stav98/Washing-Machine/src/Readme.md

Όλος ο πηγαίος κώδικας για το ESP32.
Χρησιμοποιώ και τους δύο πυρήνες του controller.
