stav98/Washing-Machine/harware/Readme.md

Εδώ υπάρχουν τα σχέδια σε pdf και sch για eagle.
