stav98/Washing-Machine/harware/WashingMachine.pdf

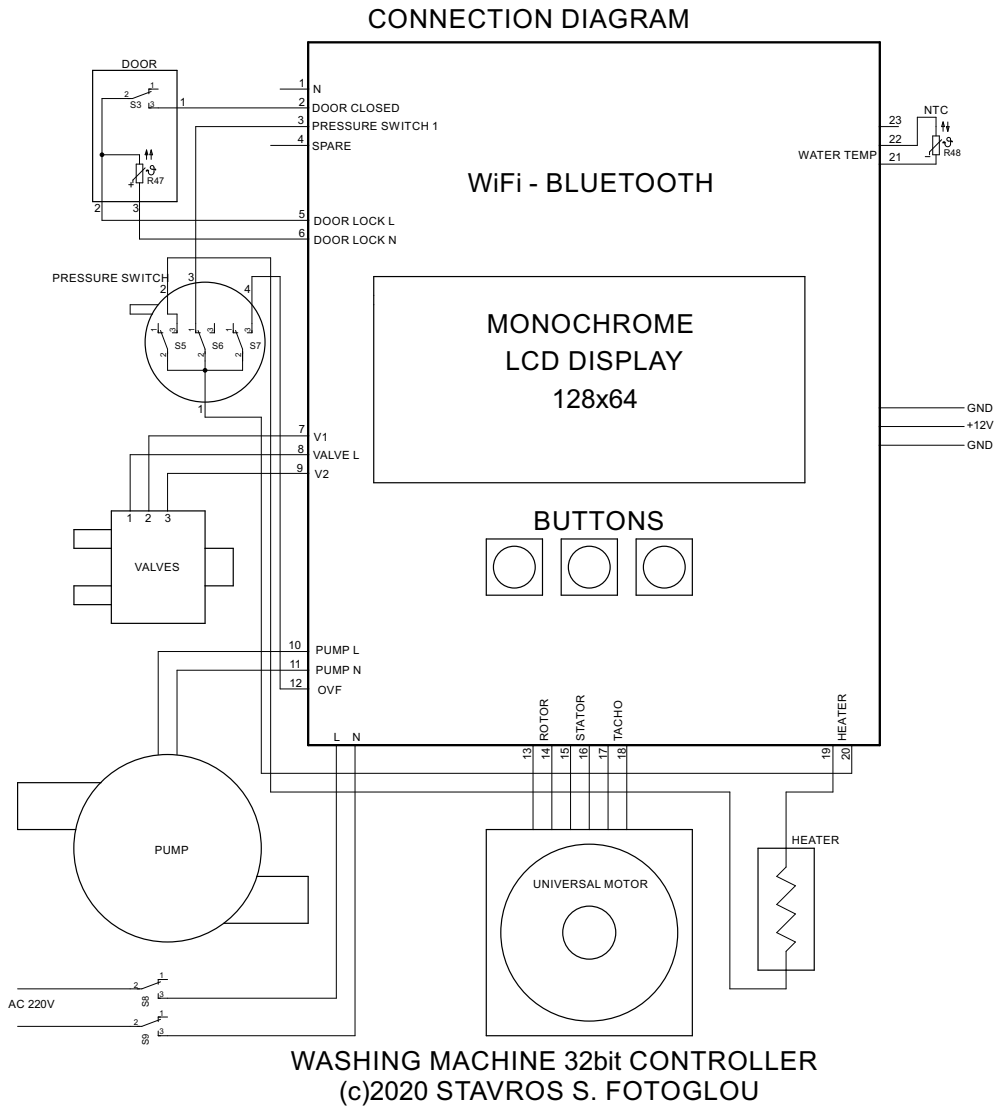
[picture p1: page 1]

10
11

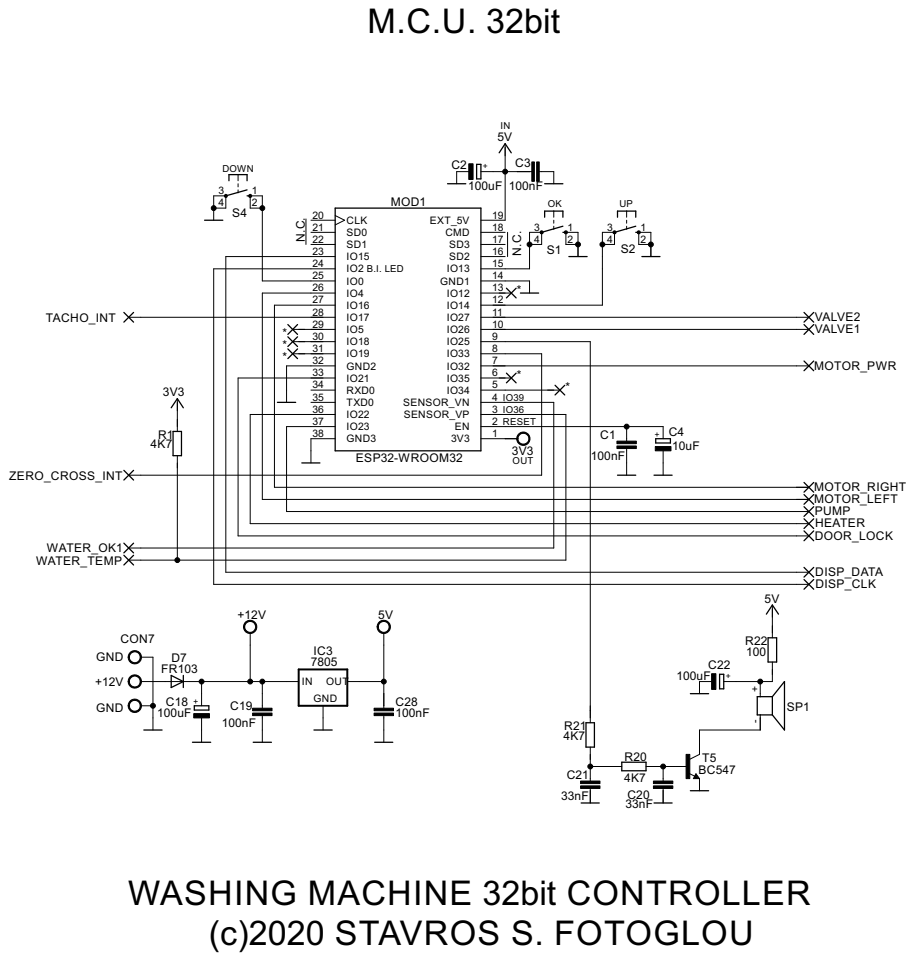
[picture p2: page 2]

2 SENSOR_VP RESET

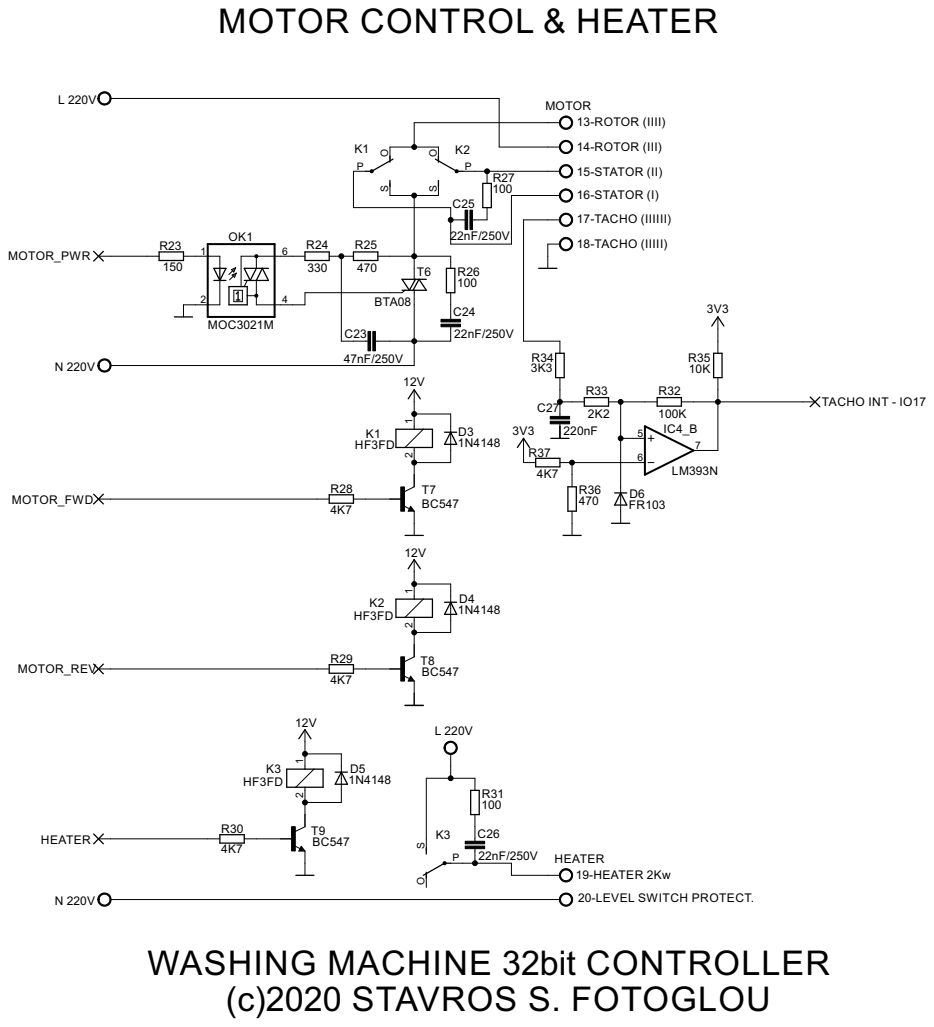
[picture p3: page 3]

MOTOR
13-ROTOR (IIII) 14-ROTOR (III) 15-STATOR (II) 16-STATOR (I) 17-TACHO (IIIIII) 18-TACHO (IIIII)

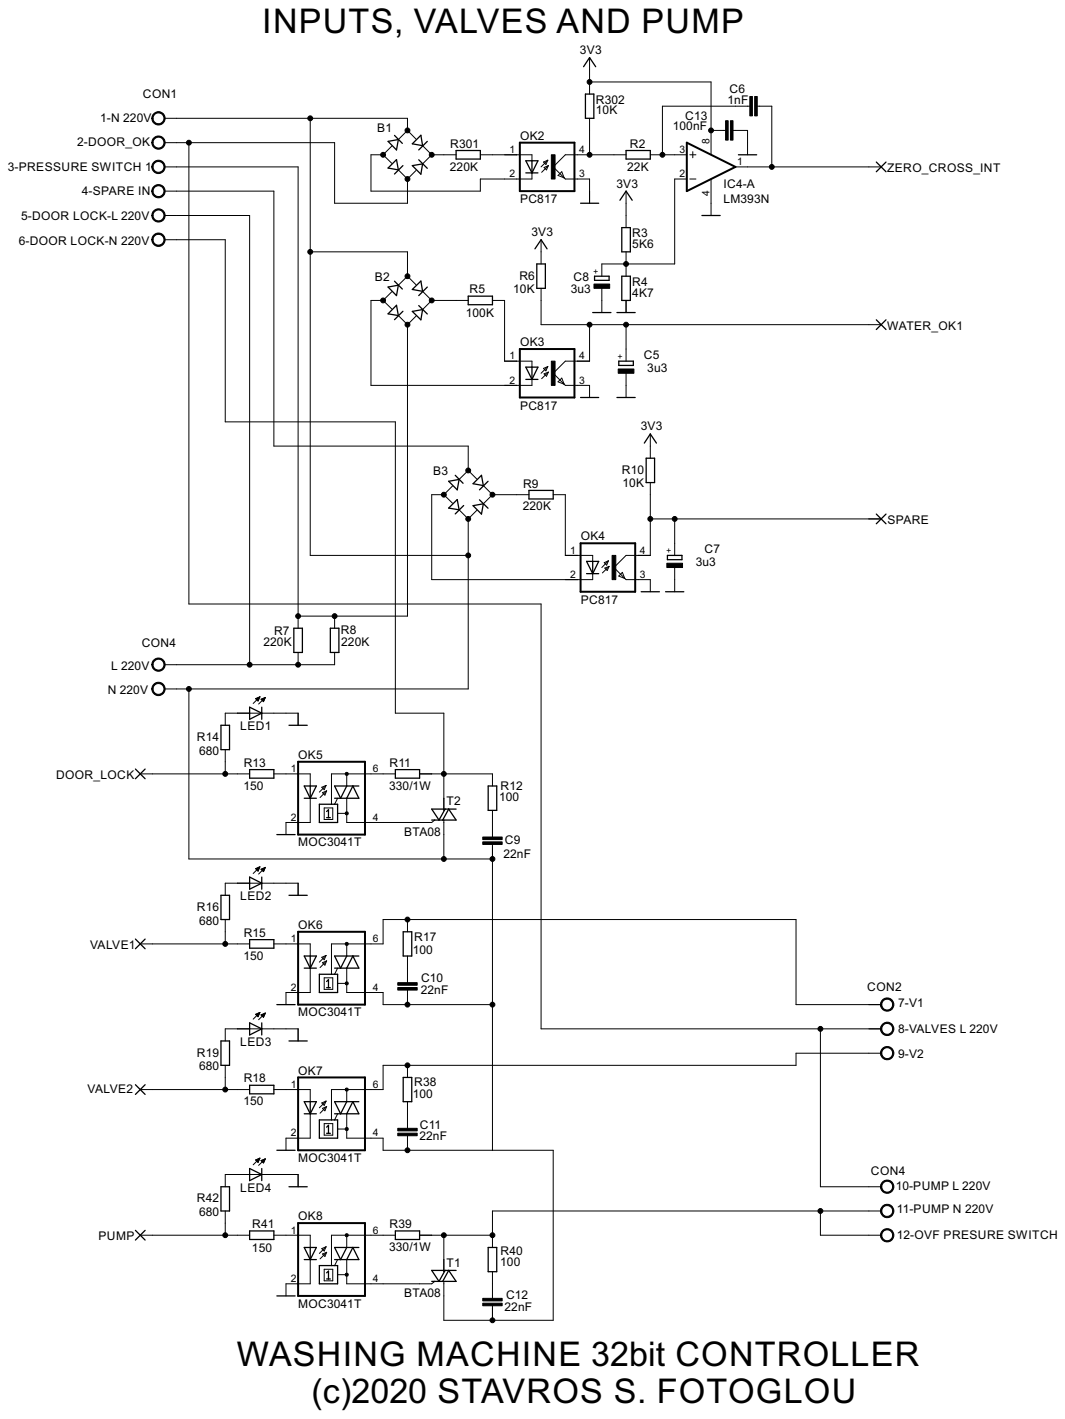
[picture p4: page 4]

INPUTS, VALVES AND PUMP

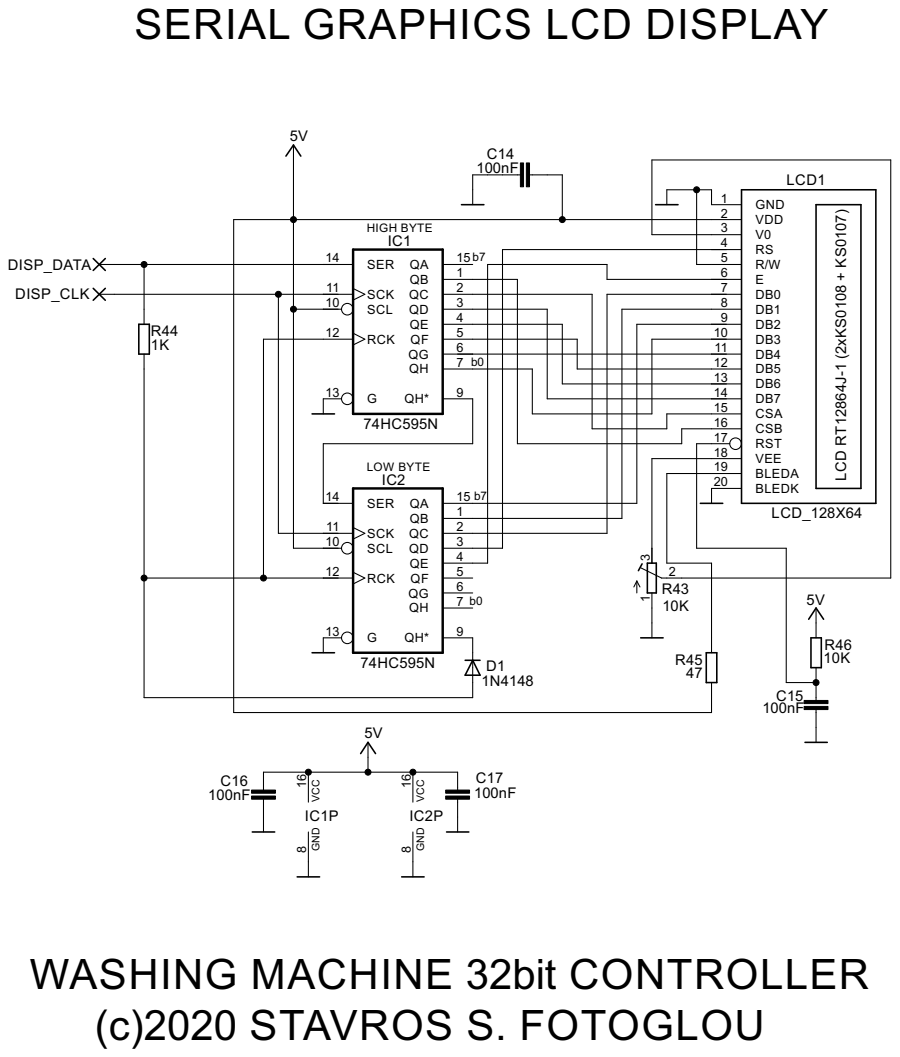
[picture p5: page 5]

SERIAL GRAPHICS LCD DISPLAY

1 QC
2 QD
3 QE
4 QF 5 QG
