stav98/Washing-Machine/harware/WashingMachine.sch

## EAGLE design harware/WashingMachine.sch (2020-10-03)

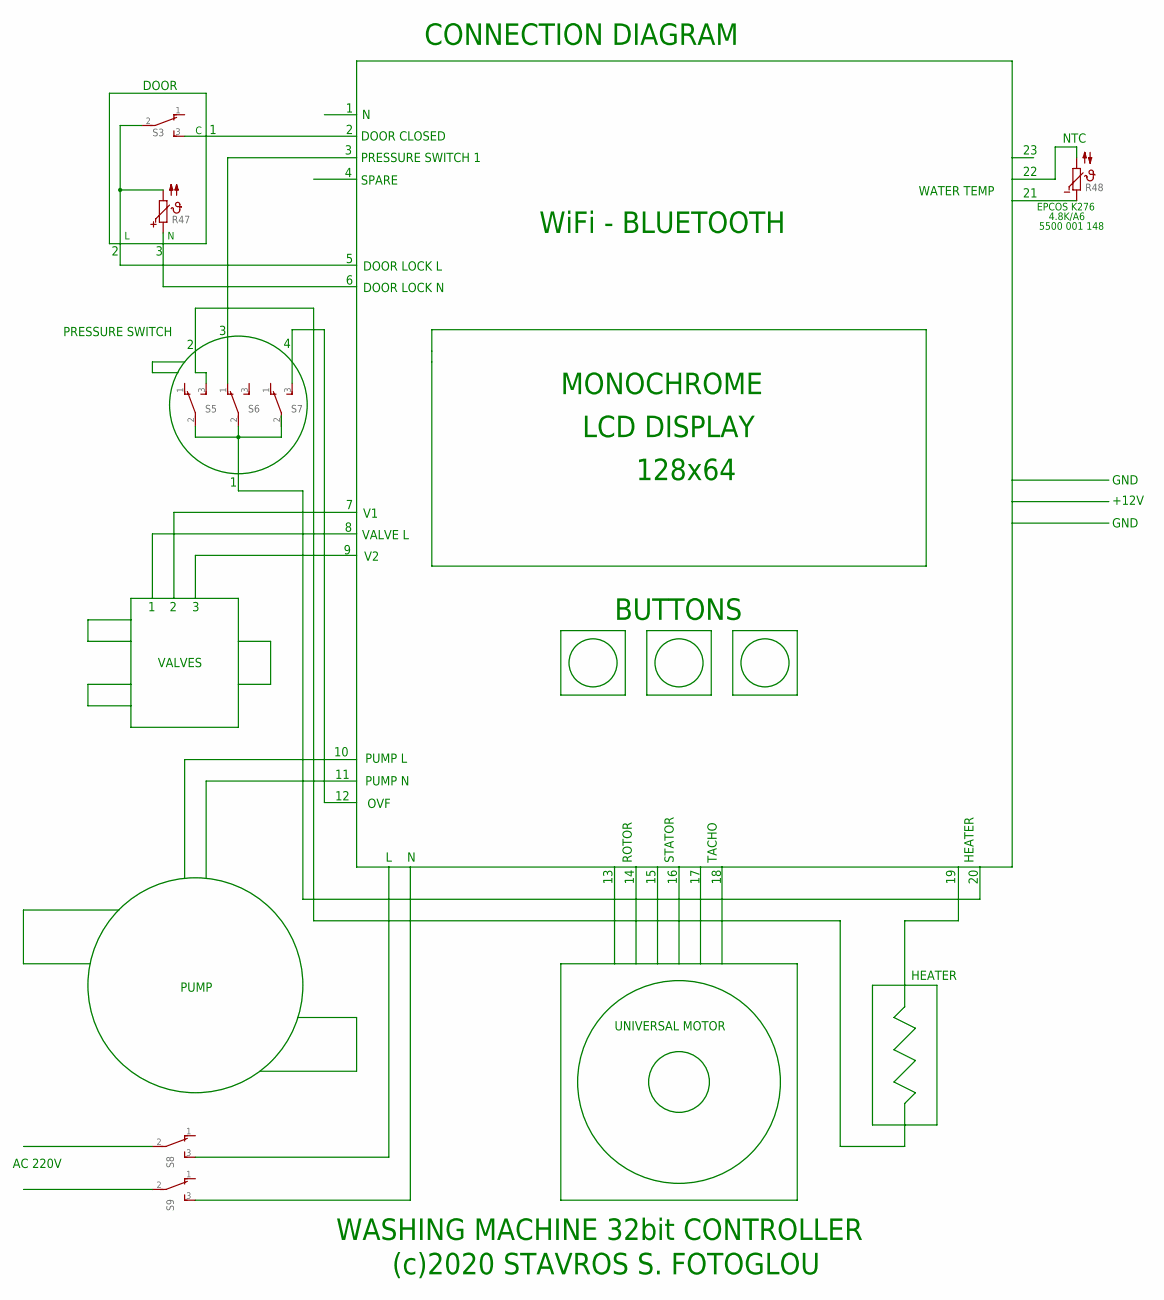
[picture p6: schematic WashingMachine.sch, sheet 1]

Parts:
R47: PTC679; P679
R48: NTC640-9; N640
S3, S5, S6, S7, S8, S9: TL36WO; TL3XWO

Connections:
unnamed: R47.1, R47.2, R48.1, R48.2, S3.2, S3.3 (S), S5.2, S5.3 (S), S6.1 (O), S6.2, S7.2, S7.3 (S), S8.3 (S), S9.3 (S)

Notes on the sheet:
DOOR CLOSED
DOOR LOCK L
DOOR LOCK N
PRESSURE SWITCH 1
DOOR
PRESSURE SWITCH
VALVE L
PUMP L
PUMP N
OVF
AC 220V
ROTOR
STATOR
TACHO
HEATER
GND
+12V
UNIVERSAL MOTOR
PUMP
VALVES
NTC
MONOCHROME
LCD DISPLAY
128x64
BUTTONS
WiFi - BLUETOOTH
WATER TEMP
SPARE
WASHING MACHINE 32bit CONTROLLER
(c)2020 STAVROS S. FOTOGLOU
CONNECTION DIAGRAM
EPCOS K276
4.8K/A6
5500 001 148

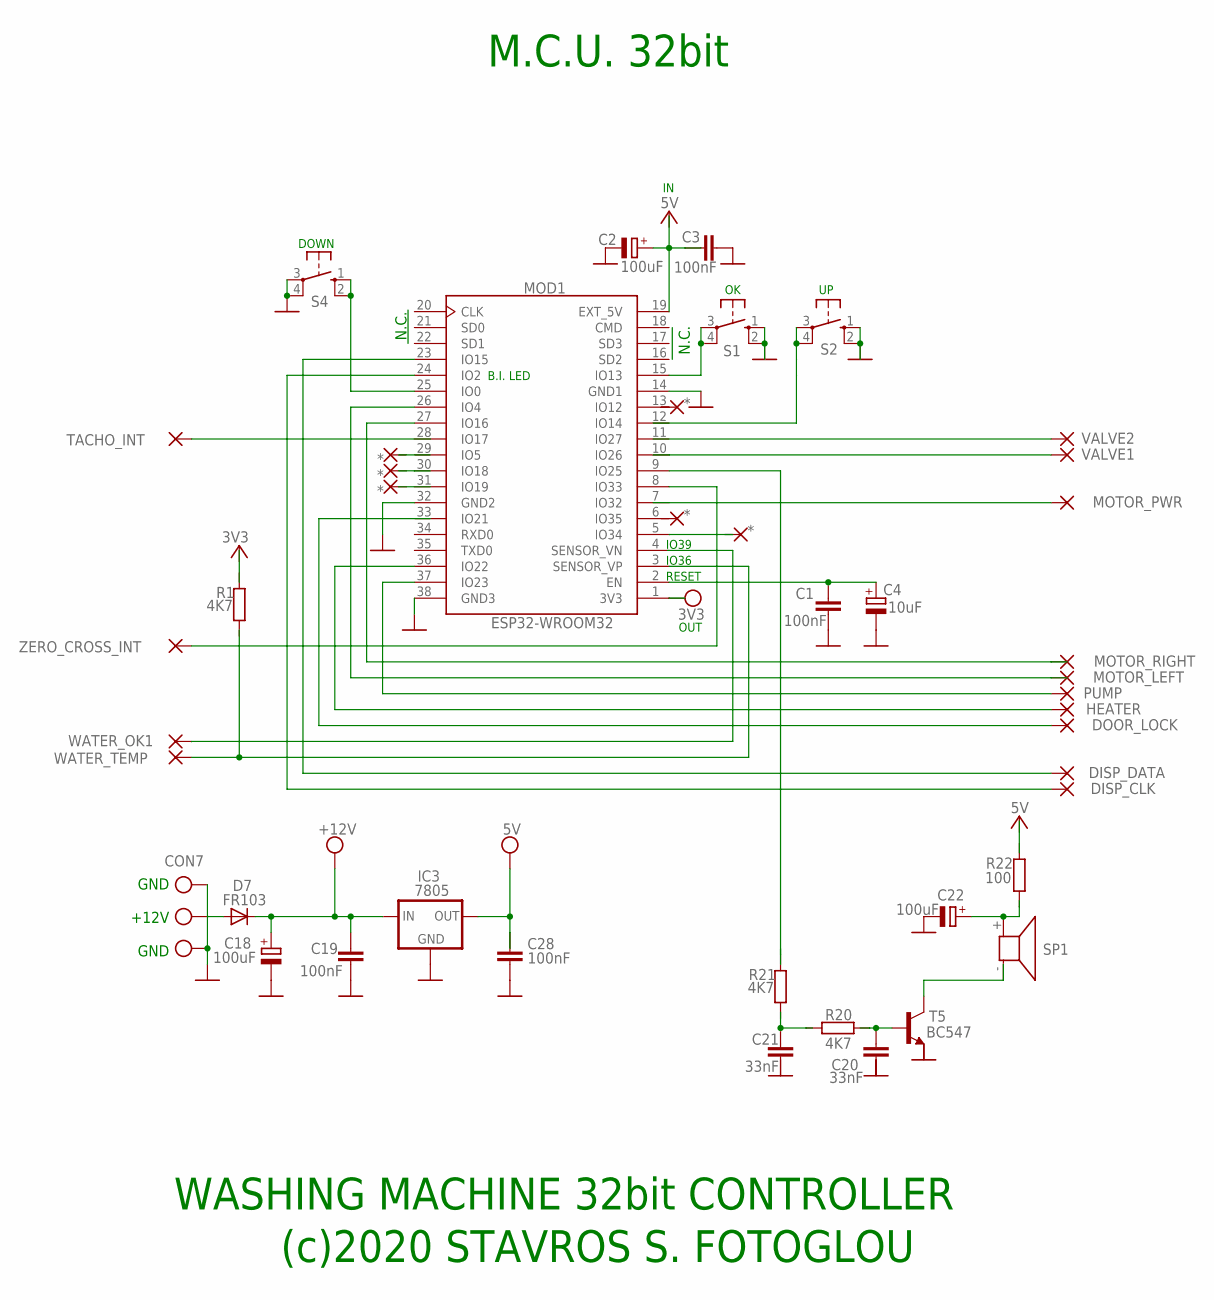
[picture p7: schematic WashingMachine.sch, sheet 2]

Parts:
C1, C3, C19, C28: 100nF; C2.5-2
C2, C18, C22: 100uF; E5-6
C4: 10uF; E5-6
C20, C21: 33nF; C2.5-2
D7: FR103; DO41-10
IC3: 7805; 78XXL
MOD1: ESP32-WROOM32; MODULE_ESP32-DEVKITC-32U
PAD1: MOTOR_RIGHT; 1,6/0,8
PAD2: MOTOR_LEFT; 1,6/0,8
PAD3: TACHO_INT; 1,6/0,8
PAD4: VALVE1; 1,6/0,8
PAD5: VALVE2; 1,6/0,8
PAD6: PUMP; 1,6/0,8
PAD7: HEATER; 1,6/0,8
PAD8: DOOR_LOCK; 1,6/0,8
PAD9: WATER_OK1; 1,6/0,8
PAD10: DISP_DATA; 1,6/0,8
PAD11: DISP_CLK; 1,6/0,8
PAD13, PAD14, PAD15, PAD24, PAD25, PAD34: *; 1,6/0,8
PAD30: WATER_TEMP; 1,6/0,8
PAD31: ZERO_CROSS_INT; 1,6/0,8
PAD32: MOTOR_PWR; 1,6/0,8
R1, R20, R21: 4K7; 0204/7
R22: 100; 0204/7
S1, S2, S4: 10-XX; B3F-10XX
SP1: AL11P
T5: BC547; TO92
X10: CON7; AK500/3

Connections:
GND: C1.2, C2.-, C3.1, C4.-, C18.-, C19.2, C22.-, C28.2, IC3.GND, MOD1.14 (GND1), MOD1.32 (GND2), MOD1.38 (GND3), S1.1 (S), S1.2 (S1), S2.1 (S), S2.2 (S1), S4.3, S4.4 (P1), X10.1, X10.3
unnamed: MOD1.3 (SENSOR_VP), PAD30.1
unnamed: MOD1.26 (IO4), PAD2.1
unnamed: MOD1.10 (IO26), PAD4.1
unnamed: MOD1.27 (IO16), PAD1.1
unnamed: MOD1.8 (IO33), PAD31.1
unnamed: MOD1.37 (IO23), PAD6.1
unnamed: MOD1.36 (IO22), PAD7.1
unnamed: C1.1, C4.+, MOD1.2 (EN)
unnamed: MOD1.23 (IO15), PAD10.1
unnamed: MOD1.24 (IO2), PAD11.1
unnamed: MOD1.15 (IO13), S1.3, S1.4 (P1)
unnamed: S2.3, S2.4 (P1)
unnamed: MOD1.25 (IO0), S4.1 (S), S4.2 (S1)
unnamed: D7.A, X10.2
unnamed: C20.1, R20.1, T5.2 (B)
unnamed: C21.1, R20.2, R21.2
unnamed: SP1.- (1), T5.3 (C)
unnamed: MOD1.9 (IO25), R21.1
unnamed: C22.+, R22.2, SP1.+ (2)
unnamed: C2.+, C3.2, MOD1.19 (EXT_5V)
VCC: C18.+, C19.1, C28.1, D7.C, IC3.IN, IC3.OUT, MOD1.1 (3V3)

Notes on the sheet:
RESET
IO39
IO36
N.C.
B.I. LED
DOWN
WASHING MACHINE 32bit CONTROLLER
(c)2020 STAVROS S. FOTOGLOU
OUT
M.C.U. 32bit
GND
+12V

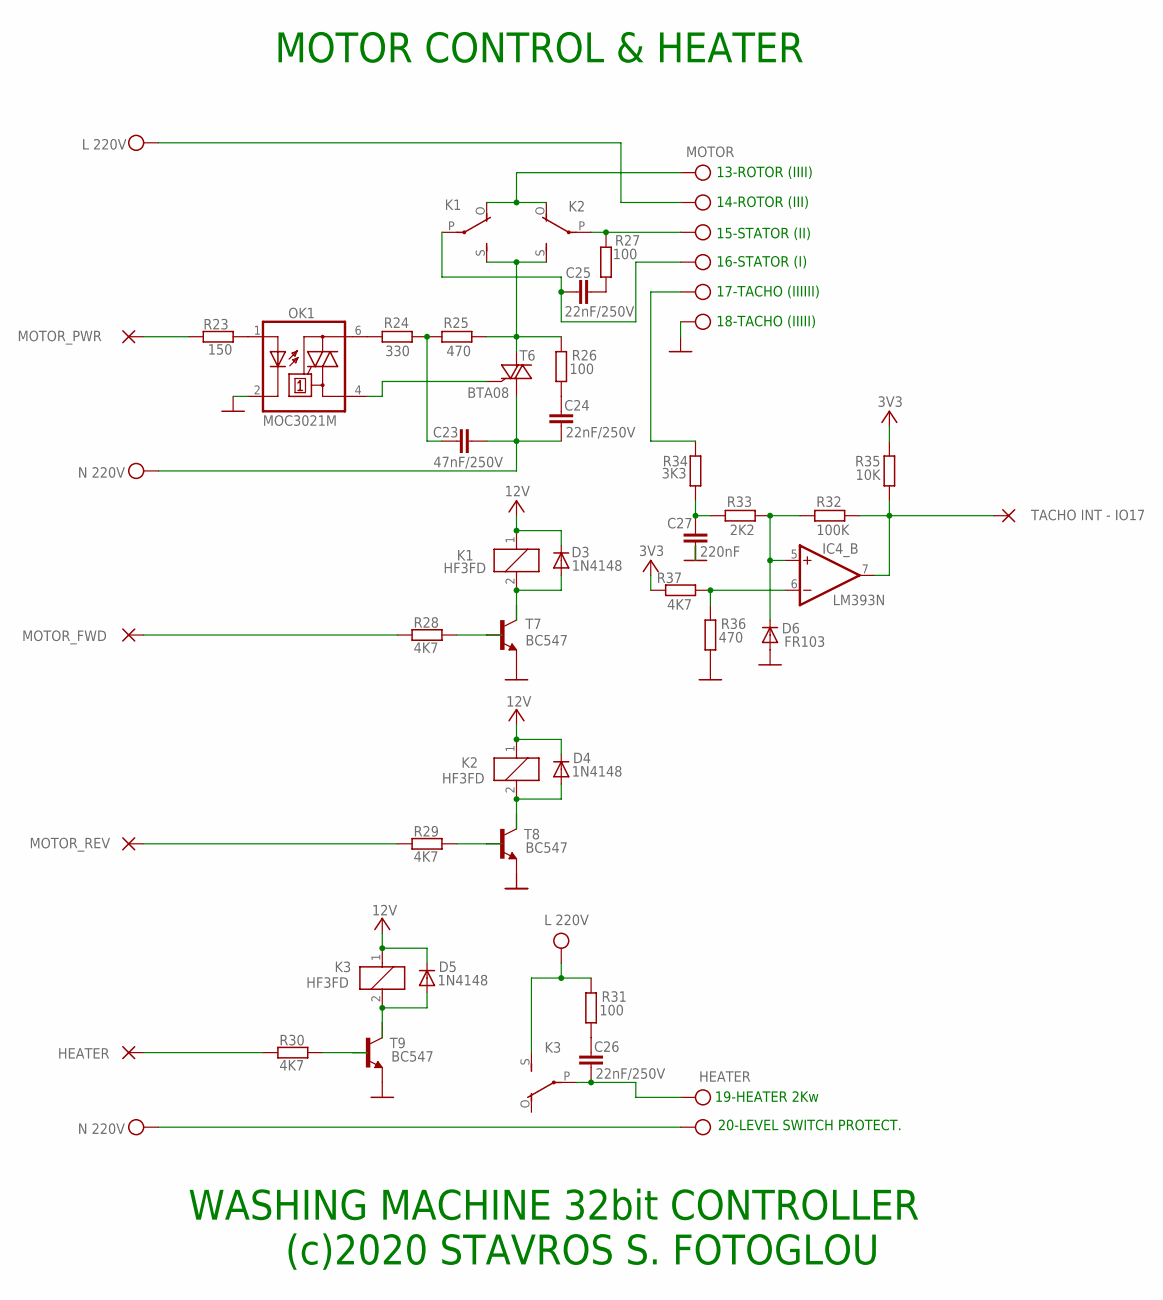
[picture p8: schematic WashingMachine.sch, sheet 3]

Parts:
C23: 47nF/250V; C050-025X075
C24, C25, C26: 22nF/250V; C050-025X075
C27: 220nF; C050-025X075
D3, D4, D5: 1N4148; DO35-10
D6: FR103; DO41-10
IC4_: LM393N; DIL08
K1, K2, K3: HF3FD; G5LE
OK1: MOC3021M; DIL06
PAD36: MOTOR_PWR; 2,15/1,0
PAD37: MOTOR_FWD; 2,15/1,0
PAD38: MOTOR_REV; 2,15/1,0
PAD39: HEATER; 2,15/1,0
PAD40: TACHO INT - IO17; 2,15/1,0
R23: 150; 0204/7
R24: 330; 0204/7
R25, R36: 470; 0204/7
R26, R27, R31: 100; 0204/7
R28, R29, R30, R37: 4K7; 0204/7
R32: 100K; 0204/7
R33: 2K2; 0204/7
R34: 3K3; 0204/7
R35: 10K; 0204/7
T6: BTA08; TO220AB
T7, T8, T9: BC547; TO92
X1: MOTOR; AK500/6
X2: HEATER; AK500/2

Connections:
GND: C27.1, D6.A, OK1.2 (C), R36.1, T7.1 (E), T8.1 (E), T9.1 (E), X1.1
unnamed: OK1.1 (A), R23.2
unnamed: PAD36.1, R23.1
unnamed: OK1.6 (A2), R24.1
unnamed: C23.1, R24.2, R25.1
unnamed: OK1.4 (A1), T6.3 (G)
unnamed: K1.S, K2.S, R25.2, R26.2, T6.2 (A2)
unnamed: K2.P, R27.2, X1.4
unnamed: C24.2, R26.1
unnamed: C25.1, K1.P, X1.3
unnamed: K1.O, K2.O, X1.6
unnamed: C25.2, R27.1
unnamed: PAD37.1, R28.1
unnamed: R28.2, T7.2 (B)
unnamed: D3.A, K1.2, T7.3 (C)
unnamed: PAD39.1, R30.1
unnamed: PAD38.1, R29.1
unnamed: R29.2, T8.2 (B)
unnamed: D4.A, K2.2, T8.3 (C)
unnamed: R30.2, T9.2 (B)
unnamed: D5.A, K3.2, T9.3 (C)
unnamed: C26.2, R31.1
unnamed: C26.1, K3.P, X2.2
unnamed: D6.C, IC4_.5 (+IN), R32.1, R33.2
unnamed: IC4_.7 (OUT), PAD40.1, R32.2, R35.1
unnamed: C27.2, R33.1, R34.1
unnamed: IC4_.6 (-IN), R36.2, R37.1
unnamed: R34.2, X1.2
VCC: C23.2, C24.1, D3.C, D4.C, D5.C, K1.1, K2.1, K3.1, K3.S, R31.2, R35.2, R37.2, T6.1 (A1), X1.5, X2.1

Notes on the sheet:
13-ROTOR (IIII)
14-ROTOR (III)
15-STATOR (II)
16-STATOR (I)
17-TACHO (IIIIII)
18-TACHO (IIIII)
19-HEATER 2Kw
20-LEVEL SWITCH PROTECT.
MOTOR CONTROL & HEATER
WASHING MACHINE 32bit CONTROLLER
(c)2020 STAVROS S. FOTOGLOU

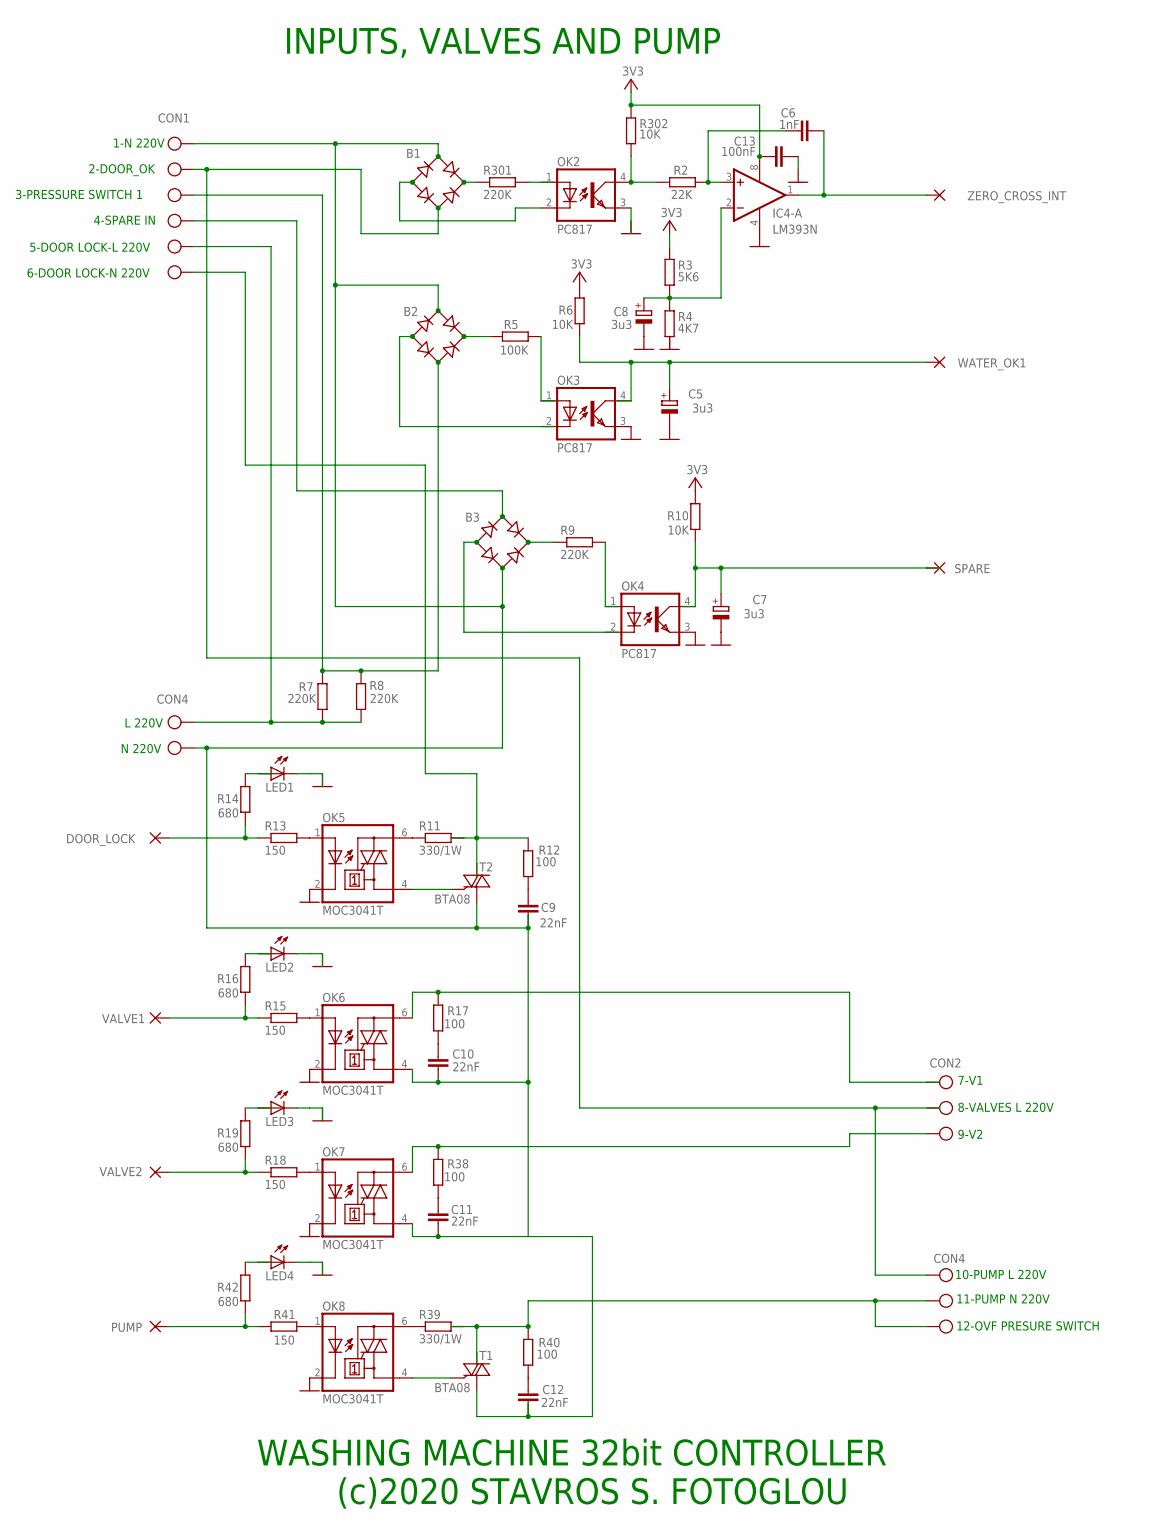
[picture p9: schematic WashingMachine.sch, sheet 4]

Parts:
B1, B2, B3: DBDB101G; DB
C5, C7, C8: 3u3; E5-6
C6: 1nF; C050-025X075
C9, C10, C11, C12: 22nF; C050-025X075
C13: 100nF; C050-025X075
IC4-: LM393N; DIL08
LED1, LED2, LED3, LED4: LED_ELD260; LED_LD260
OK2, OK3, OK4: PC817; DIL04
OK5, OK6, OK7, OK8: MOC3041T; DIL06B
PAD12: DOOR_LOCK; 1,6/0,8
PAD16: ZERO_CROSS_INT; 1,6/0,8
PAD17: WATER_OK1; 1,6/0,8
PAD18: SPARE; 1,6/0,8
PAD19: VALVE1; 1,6/0,8
PAD20: VALVE2; 1,6/0,8
PAD21: PUMP; 1,6/0,8
R2: 22K; 0204/7
R3: 5K6; 0204/7
R4: 4K7; 0204/7
R5: 100K; 0204/7
R6, R10, R302: 10K; 0204/7
R7, R8, R9, R301: 220K; 0204/7
R11, R39: 330/1W; 0204/7
R12, R17, R38, R40: 100; 0204/7
R13, R15, R18, R41: 150; 0204/7
R14, R16, R19, R42: 680; 0204/7
T1, T2: BTA08; TO220AB
X3: CON1; AK500/2
X4, X6: AK500/2
X5: CON4; AK500/2
X7: CON2; AK500/3
X8: CON4; AK500/3

Connections:
GND: C5.-, C7.-, C8.-, C13.2, IC4-.4 (V-), OK3.3 (EMIT), OK4.3 (EMIT), OK5.2 (C), OK6.2 (C), OK7.2 (C), OK8.2 (C)
unnamed: B1.+, R301.1
unnamed: B1.-, OK2.2 (C)
unnamed: OK2.4 (COL), R2.1, R302.1
unnamed: B1.AC1, B2.AC1, B3.AC2, C9.1, C10.1, C11.1, C12.1, OK6.4 (A1), OK7.4 (A1), T1.1 (A1), T2.1 (A1), X3.1, X5.2
unnamed: B1.AC2, X3.2, X8.3
unnamed: C6.1, IC4-.3 (+IN), R2.2
unnamed: C6.2, IC4-.1 (OUT), PAD16.1
unnamed: OK6.6 (A2), R17.2, X7.3
unnamed: C8.+, IC4-.2 (-IN), R3.1, R4.2
unnamed: B2.+, R5.1
unnamed: OK3.1 (A), R5.2
unnamed: C5.+, OK3.4 (COL), PAD17.1, R6.1
unnamed: B3.AC1, X4.2
unnamed: B2.AC2, R7.2, R8.2, X4.1
unnamed: R7.1, R8.1, X5.1, X6.1
unnamed: B3.+, R9.1
unnamed: OK5.4 (A1), T2.3 (G)
unnamed: OK4.1 (A), R9.2
unnamed: C7.+, OK4.4 (COL), PAD18.1, R10.1
unnamed: OK5.6 (A2), R11.1
unnamed: R11.2, R12.2, T2.2 (A2), X6.2
unnamed: C9.2, R12.1
unnamed: OK5.1 (A), R13.2
unnamed: PAD12.1, R13.1, R14.1
unnamed: LED1.A, R14.2
unnamed: LED1.K (C), LED2.K (C), LED3.K (C), LED4.K (C)
unnamed: OK7.1 (A), R18.2
unnamed: OK6.1 (A), R15.2
unnamed: PAD19.1, R15.1, R16.1
unnamed: LED2.A, R16.2
unnamed: C10.2, R17.1
unnamed: PAD20.1, R18.1, R19.1
unnamed: LED3.A, R19.2
unnamed: C11.2, R38.1
unnamed: OK7.6 (A2), R38.2, X7.1
unnamed: OK8.4 (A1), T1.3 (G)
unnamed: OK8.6 (A2), R39.1
unnamed: R39.2, R40.2, T1.2 (A2), X8.1, X8.2
unnamed: C12.2, R40.1
unnamed: OK8.1 (A), R41.2
unnamed: PAD21.1, R41.1, R42.1
unnamed: LED4.A, R42.2
VCC: C13.1, IC4-.8 (V+), R3.2, R6.2, R10.2, R302.2

Notes on the sheet:
1-N 220V
2-DOOR_OK
L 220V
3-PRESSURE SWITCH 1
N 220V
4-SPARE IN
5-DOOR LOCK-L 220V
6-DOOR LOCK-N 220V
7-V1
8-VALVES L 220V
9-V2
10-PUMP L 220V
11-PUMP N 220V
12-OVF PRESURE SWITCH
INPUTS, VALVES AND PUMP
WASHING MACHINE 32bit CONTROLLER
(c)2020 STAVROS S. FOTOGLOU

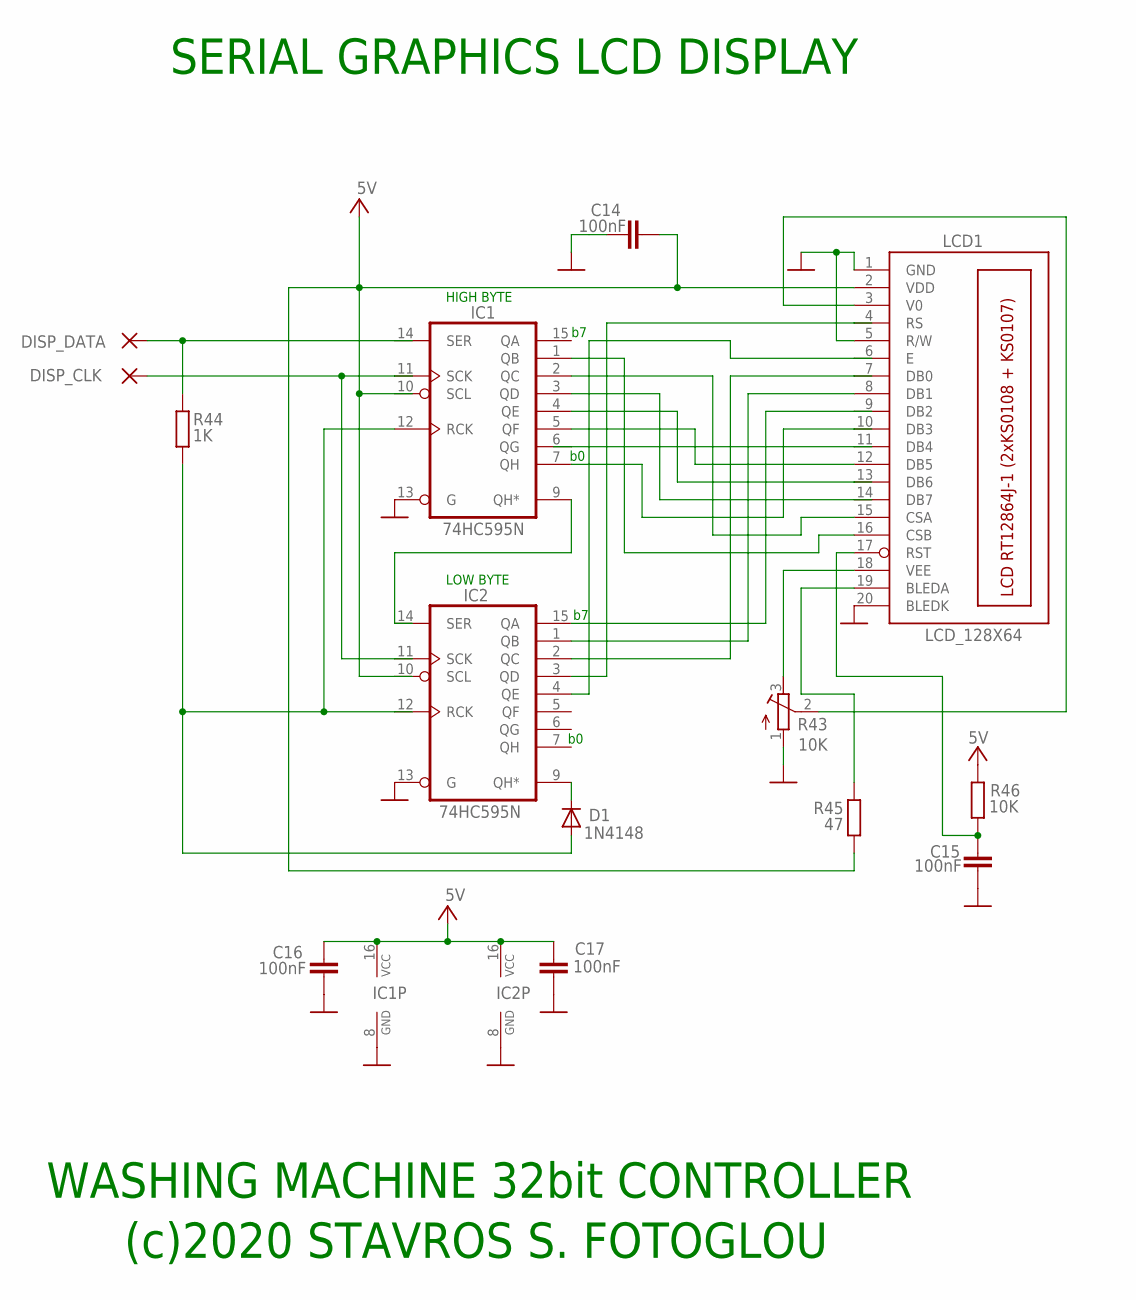
[picture p10: schematic WashingMachine.sch, sheet 5]

Parts:
C14, C15, C16, C17: 100nF; C050-025X075
D1: 1N4148; DO35-10
IC1, IC2: 74HC595N; DIL16
LCD1: LCD_128X64; ABG128064J
PAD22: DISP_CLK; 1,6/0,8
PAD23: DISP_DATA; 1,6/0,8
R43: 10K; RTRIM3339P
R44: 1K; 0204/7
R45: 47; 0204/7
R46: 10K; 0204/7

Connections:
GND: C14.1, C15.1, C16.1, C17.1, IC1.8 (GND), IC1.13 (G), IC2.8 (GND), IC2.13 (G), LCD1.1 (GND), LCD1.5 (R/W), LCD1.20 (BLEDK), R43.1 (E)
unnamed: IC1.14 (SER), PAD23.1, R44.2
unnamed: IC1.11 (SCK), IC2.11 (SCK), PAD22.1
unnamed: IC1.9 (QH*), IC2.14 (SER)
unnamed: LCD1.18 (VEE), R43.3 (A)
unnamed: D1.A, IC1.12 (RCK), IC2.12 (RCK), R44.1
unnamed: IC1.6 (QG), LCD1.11 (DB4)
unnamed: IC1.5 (QF), LCD1.12 (DB5)
unnamed: IC1.4 (QE), LCD1.13 (DB6)
unnamed: IC1.3 (QD), LCD1.14 (DB7)
unnamed: IC1.7 (QH), LCD1.10 (DB3)
unnamed: IC2.15 (QA), LCD1.9 (DB2)
unnamed: IC2.1 (QB), LCD1.8 (DB1)
unnamed: IC2.2 (QC), LCD1.7 (DB0)
unnamed: C15.2, LCD1.17 (RST), R46.1
unnamed: IC1.2 (QC), LCD1.15 (CSA)
unnamed: IC1.1 (QB), LCD1.16 (CSB)
unnamed: IC2.3 (QD), LCD1.4 (RS)
unnamed: IC2.4 (QE), LCD1.6 (E)
unnamed: LCD1.3 (V0), R43.2 (S)
unnamed: D1.C, IC2.9 (QH*)
unnamed: LCD1.19 (BLEDA), R45.2
VCC: C14.2, C16.2, C17.2, IC1.10 (SCL), IC1.16 (VCC), IC2.10 (SCL), IC2.16 (VCC), LCD1.2 (VDD), R45.1, R46.2

Notes on the sheet:
LOW BYTE
HIGH BYTE
WASHING MACHINE 32bit CONTROLLER
(c)2020 STAVROS S. FOTOGLOU
SERIAL GRAPHICS LCD DISPLAY
