stav98/Washing-Machine/src/screen.h

#include "display.h"

Serial_Graphical_LCD_display lcd;

const byte picture [] PROGMEM = {
 0x1C, 0x22, 0x49, 0xA1, 0xA1, 0x49, 0x22, 0x1C,  // face  
 0x10, 0x08, 0x04, 0x62, 0x62, 0x04, 0x08, 0x10,  // star destroyer
 0x4C, 0x52, 0x4C, 0x40, 0x5F, 0x44, 0x4A, 0x51,  // OK logo
};

const byte door_ok[] PROGMEM = {16, 16,
           0x00, 0x1E, 0x92, 0x0C, 0x00, 0x0C, 0x12, 0x0C, 0x00, 0x0C, 0x12, 0x0C, 0x80, 0xDE, 0x44, 0x00, 0x00, 0x00, 0x01, 0x03, 0x06, 0x0C, 0x18, 0x30, 0x60, 0x38, 0x1E, 0x07, 0x01, 0x00, 0x00, 0x00 };
const byte door_nok[] PROGMEM = {16, 16, 
            0x00, 0x1E, 0x12, 0x0C, 0x00, 0x0C, 0x92, 0xCC, 0xC0, 0x8C, 0x12, 0x0C, 0x00, 0x1E, 0x04, 0x00, 0x00, 0x00, 0x00, 0x00, 0x00, 0x00, 0x03, 0x6F, 0x6F, 0x03, 0x00, 0x00, 0x00, 0x00, 0x00, 0x00 };
const byte valve1[] PROGMEM = {16, 16,
            0x00, 0xFC, 0xF8, 0xF0, 0xE0, 0xC0, 0x80, 0x24, 0x3E, 0xA0, 0xC0, 0xE0, 0xF0, 0xF8, 0xFC, 0x00, 0x00, 0x7F, 0x3F, 0x1F, 0x0F, 0x07, 0x03, 0x01, 0x01, 0x03, 0x07, 0x0F, 0x1F, 0x3F, 0x7F, 0x00 };
const byte valve2[] PROGMEM = {16, 16,
            0x00, 0xFC, 0xF8, 0xF0, 0xE0, 0xC0, 0x80, 0x3A, 0x2A, 0xAE, 0xC0, 0xE0, 0xF0, 0xF8, 0xFC, 0x00, 0x00, 0x7F, 0x3F, 0x1F, 0x0F, 0x07, 0x03, 0x01, 0x01, 0x03, 0x07, 0x0F, 0x1F, 0x3F, 0x7F, 0x00 };
const byte valve_idle[] PROGMEM = {16, 16,
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

const char msg1[] PROGMEM = {0x84, 0x8D, 0x93, 0x8F, 0x8C, 0x8E, 0x20, 0x8F, 0x8A, 0x93, 0x8C, 0x92, 0x86, 0x90, 0x88, 0x8E, 0};
const char lbl_progr[] PROGMEM = {0x8F, 0x90, 0x8E, 0x82, 0x90, 0x3A, 0};

const char lbl_eisag1[] PROGMEM = {0x84, 0x88, 0x91, 0x80, 0x82, 0x97, 0x82, 0x86, 0x20, 0x8C, 0x84, 0x90, 0x8E, 0x93, 0};
const char lbl_plisi_kr[] PROGMEM = {0x8F, 0x8A, 0x93, 0x91, 0x86, 0x20, 0x8B, 0x84, 0x20, 0x89, 0x90, 0x93, 0x8E, 0x20, 0x8C, 0x84, 0x90, 0x8E, 0};
const char lbl_plisi_zes[] PROGMEM = {0x85, 0x84, 0x91, 0x92, 0x80, 0x8B, 0x80, 0x20, 0x8C, 0x84, 0x90, 0x8E, 0x93, 0};
const char lbl_eisag_sympl[] PROGMEM = {0x91, 0x93, 0x8B, 0x8F, 0x8A, 0x86, 0x90, 0x97, 0x91, 0x86, 0x20, 0x8C, 0x84, 0x90, 0x8E, 0x93, 0};
const char lbl_plisi[] PROGMEM = {0x8F, 0x8A, 0x93, 0x91, 0x86, 0};
const char lbl_antlisi[] PROGMEM = {0x84, 0x8D, 0x80, 0x82, 0x97, 0x82, 0x86, 0x20, 0x8C, 0x84, 0x90, 0x8E, 0x93, 0};
const char lbl_spin[] PROGMEM = {0x91, 0x92, 0x93, 0x96, 0x88, 0x8B, 0x8E, 0};
const char lbl_finish[] PROGMEM = {0x92, 0x84, 0x90, 0x8B, 0x80, 0x92, 0x88, 0x91, 0x8B, 0x8E, 0x91, 0};

void intro()
 {
  lcd.clear();
  lcd.img(wm1, 43, 8);
  delay(5000);
  lcd.clear();
  lcd.selectFont(font_cp437);
  lcd.textSize(1);
  lcd.print(PGMSTR(msg1));
  lcd.line (0, 10, 127, 10, 1);
  lcd.selectFont(font_fixed_5x8);
  lcd.gotoxy (30, 16);
  lcd.print("(c)2020 by"); 
  lcd.gotoxy (10, 24);
  lcd.print("Stavros S. Fotoglou");
  delay(5000);
 }

 void front_page()
 {
  lcd.clear();
  lcd.selectFont(font_cp437);
  lcd.print(PGMSTR(lbl_progr));
  lcd.selectFont(font_fixed_5x8);
  char tmp[] = {0x89, 0x80, 0x8C, 0x8E, 0x8C, 0x88, 0x89, 0x8E, 0}; //ΚΑΝΟΝΙΚΟ
  lcd.setInv(true);
  lcd.print(tmp);
  lcd.setInv(false);

  lcd.frameRect (0, 10, 127, 12, 1, 1);
  //lcd.fillCircle(30, 11, 4, 1);
  
  lcd.line(0, 16, 0, 30, 1);
  lcd.img(temp_icon, 2, 16);
  lcd.selectFont(font_fixed_3x5);
  lcd.gotoxy (6, 24);
  lcd.print("65");
  lcd.line(5, 30, 14, 30, 1);
  
  lcd.line(19, 16, 19, 30, 1);
  lcd.img(spin_none, 21, 16);

  lcd.line(38, 16, 38, 30, 1);
  lcd.img(propl_no, 40, 16);
  
  lcd.line(57, 16, 57, 30, 1);
  lcd.img(prog_fast, 59, 16);
  
  lcd.line(76, 16, 76, 30, 1);
  lcd.line(77, 16, 77, 30, 1);
  lcd.img(next_icon, 79, 16);
  
  //lcd.selectFont(font_fixed_5x8);
  //lcd.gotoxy(96, 16);
  //lcd.printf("%03d'", 0);
  //lcd.setInv(false);

  lcd.selectFont(font_fixed_3x5);
  lcd.gotoxy (96, 24);
  lcd.print("RPM:");

  lcd.selectFont(font_fixed_5x8);
  lcd.gotoxy (0, 32);
  lcd.print("SYNTOMO: Yes"); 
 }
 
 void status_bar()
 {
  lcd.line (0, 46, 127, 46, 1);
  byte x=2;
  lcd.img(door_nok, x, 48);
  x += 17;
  lcd.img(pressure_sw_nok, x, 48);
  x += 18;
  lcd.selectFont(font_fixed_3x5);
  lcd.gotoxy(x, 48);
  lcd.print("TEMP");
  //lcd.gotoxy(x, 56);
  //lcd.print(w_temp);
  x += 8;
  lcd.gotoxy(x, 56);
  lcd.putch(127);
  lcd.putch('C');
  x += 10;
  lcd.line (x, 46, x, 63, 1);
  x += 2;
  lcd.img(valve_idle, x, 48);
  x += 17;
  lcd.img(pump, x, 48);
  x += 17;
  lcd.img(motor_idle, x, 48);
  x += 17;
  lcd.img(heater, x, 48);
  //x += 17;
  //lcd.img(motor_spin, x, 48);
  //lcd.gotoxy(82, 32);
  //lcd.print(avg_rpm);
 }
