stav98/Washing-Machine/src/display_CG.h

const byte font_fixed_5x8[] PROGMEM = {
//const byte font[] PROGMEM = {
    0, 0, // size of zero indicates fixed width font,
    5, // width
    8, // height
   32, // first char
  (151-32), // char count
    1, // x-padding
  //-------------- CG Data -----------------
  0x00, 0x00, 0x00, 0x00, 0x00,// (space) 32
  0x00, 0x00, 0x5F, 0x00, 0x00,// !
  0x00, 0x07, 0x00, 0x07, 0x00,// "
  0x14, 0x7F, 0x14, 0x7F, 0x14,// #
  0x24, 0x2A, 0x7F, 0x2A, 0x12,// $
  0x23, 0x13, 0x08, 0x64, 0x62,// %
  0x36, 0x49, 0x55, 0x22, 0x50,// &
  0x00, 0x05, 0x03, 0x00, 0x00,// '
  0x00, 0x1C, 0x22, 0x41, 0x00,// (   40
  0x00, 0x41, 0x22, 0x1C, 0x00,// )
  0x08, 0x2A, 0x1C, 0x2A, 0x08,// *
  0x08, 0x08, 0x3E, 0x08, 0x08,// +
  0x00, 0x50, 0x30, 0x00, 0x00,// ,
  0x08, 0x08, 0x08, 0x08, 0x08,// -
  0x00, 0x60, 0x60, 0x00, 0x00,// .
  0x20, 0x10, 0x08, 0x04, 0x02,// /
  0x3E, 0x51, 0x49, 0x45, 0x3E,// 0
  0x00, 0x42, 0x7F, 0x40, 0x00,// 1
  0x42, 0x61, 0x51, 0x49, 0x46,// 2   50
  0x21, 0x41, 0x45, 0x4B, 0x31,// 3
  0x18, 0x14, 0x12, 0x7F, 0x10,// 4
  0x27, 0x45, 0x45, 0x45, 0x39,// 5
  0x3C, 0x4A, 0x49, 0x49, 0x30,// 6
  0x01, 0x71, 0x09, 0x05, 0x03,// 7
  0x36, 0x49, 0x49, 0x49, 0x36,// 8
  0x06, 0x49, 0x49, 0x29, 0x1E,// 9
  0x00, 0x36, 0x36, 0x00, 0x00,// :
  0x00, 0x56, 0x36, 0x00, 0x00,// ;
  0x00, 0x08, 0x14, 0x22, 0x41,// <   60
  0x14, 0x14, 0x14, 0x14, 0x14,// =
  0x41, 0x22, 0x14, 0x08, 0x00,// >
  0x02, 0x01, 0x51, 0x09, 0x06,// ?
  0x32, 0x49, 0x79, 0x41, 0x3E,// @
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
0x63,0x49,0x49,0x49,0x49,0x49,0x63, //'Ξ'
28,  62,  99,  65,  99,  62,  28,    //'O'
0x7f,0x7f,0x01,0x01,0x01,0x7f,0x7f, //'Π'
65, 127, 127,  73,   9,  15,   6,    //'P'
0x41,0x63,0x77,0x5d,0x49,0x41,0x63, //'Σ'
3,  65, 127, 127,  65,   3,   0,    //'T'
 7,  79, 120, 120,  79,   7,   0,    //'Y'
0x1C, 0x22, 0x22, 0x7F, 0x22, 0x22, 0x1C,  //'Φ'
67, 103,  60,  24,  60, 103,  67,    //'X'
0x07, 0x0F, 0x48, 0x7E, 0x48, 0x0F, 0x07,  //'Ψ'      150
0x4c,0x5e,0x73,0x01,0x73,0x5e,0x4c, //'Ω'
0x20, 0x70, 0x50, 0x50, 0x38, 0x78, 0x40,  //α
0x00, 0x10, 0x3E, 0x49, 0x4D, 0x4A, 0x30, //β
};
